Cdcuellar/Sistemas-embebidos---Actividades-de-la-vida-diaria/esp32_1_hr_rstc_sd_master/esp32_1_hr_rtc_sd_master.png

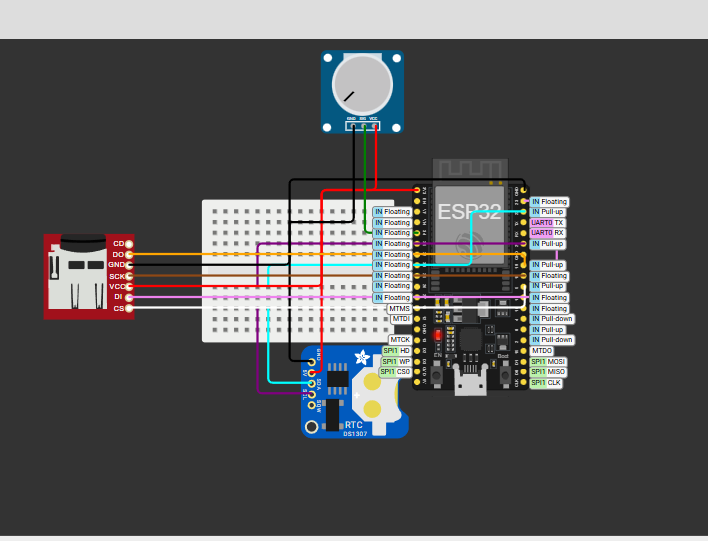
esp32_1_hr_rstc_sd_master/esp32_1_hr_rtc_sd_master.png
