Cdcuellar/Sistemas-embebidos---Actividades-de-la-vida-diaria/esp32_2/esp32_2.png

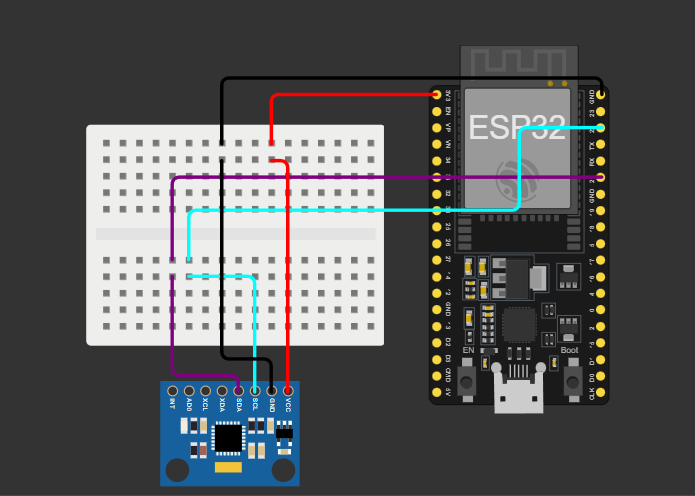
esp32_2/esp32_2.png
