Cdcuellar/Sistemas-embebidos---Actividades-de-la-vida-diaria/sta_wifi/build_output.txt

Checking Python dependencies...
Python requirements are satisfied.

Constraint file: C:\Espressif\tools\espidf.constraints.v6.0.txt

Requirement files:

 - C:\esp\v6.0\esp-idf\tools\requirements\requirements.core.txt

Python being checked: C:\Espressif\tools\python\v6.0\venv\Scripts\python.exe
Checking used Python interpreter...
Executing action: all (aliases: build)
Running cmake in directory C:\Users\Daniel\sta_wifi\build
Executing "cmake -G Ninja -B C:\Users\Daniel\sta_wifi\build -DPYTHON_DEPS_CHECKED=1 -DPYTHON=C:\Espressif\tools\python\v6.0\venv\Scripts\python.exe -DESP_PLATFORM=1 -DCCACHE_ENABLE=False C:\Users\Daniel\sta_wifi"...
-- IDF_TARGET is not set, guessed 'esp32' from sdkconfig 'C:/Users/Daniel/sta_wifi/sdkconfig'
-- Found Git: C:/Program Files/Git/cmd/git.exe (found version "2.51.2.windows.1")
-- Component directory C:/esp/v6.0/esp-idf/components/mqtt does not contain a CMakeLists.txt file. No component will be added
-- Minimal build - OFF
-- The C compiler identification is GNU 15.2.0
-- The CXX compiler identification is GNU 15.2.0
-- The ASM compiler identification is GNU
-- Found assembler: C:/Espressif/tools/xtensa-esp-elf/esp-15.2.0_20251204/xtensa-esp-elf/bin/xtensa-esp32-elf-gcc.exe
-- Detecting C compiler ABI info
-- Detecting C compiler ABI info - done
-- Check for working C compiler: C:/Espressif/tools/xtensa-esp-elf/esp-15.2.0_20251204/xtensa-esp-elf/bin/xtensa-esp32-elf-gcc.exe - skipped
-- Detecting C compile features
-- Detecting C compile features - done
-- Detecting CXX compiler ABI info
-- Detecting CXX compiler ABI info - done
-- Check for working CXX compiler: C:/Espressif/tools/xtensa-esp-elf/esp-15.2.0_20251204/xtensa-esp-elf/bin/xtensa-esp32-elf-g++.exe - skipped
-- Detecting CXX compile features
-- Detecting CXX compile features - done
-- Building ESP-IDF components for target esp32
-- ESP-TEE is currently supported only on the esp32c6;esp32h2;esp32c5;esp32c61 SoCs
-- KCONFIG_REPORT_VERBOSITY not set, using default
-- Project sdkconfig file C:/Users/Daniel/sta_wifi/sdkconfig
C:\Espressif\tools\python\v6.0\venv\Scripts\python.exe : Configuration Report  
             
En C:\Espressif\tools\Microsoft.v6.0.PowerShell_profile.ps1: 96 Carácter: 5
+     C:\Espressif\tools\python\v6.0\venv\Scripts\python.exe C:\esp\v6. ...
+     ~~~~~~~~~~~~~~~~~~~~~~~~~~~~~~~~~~~~~~~~~~~~~~~~~~~~~~~~~~~~~~~~~
    + CategoryInfo          : NotSpecified: (Configuration Report              
     :String) [], RemoteException
    + FullyQualifiedErrorId : NativeCommandError

+---------------------------------+

|  Parser Version: 1              |

|  Verbosity: default             |

|  Defaults policy: sdkconfig     |

|  Status: Finished successfully  |

|                                 |

+---------------------------------+

-- Compiler supported targets: xtensa-esp-elf
-- Detecting C compiler ABI info
-- Detecting C compiler ABI info - done
-- Detecting CXX compiler ABI info
-- Detecting CXX compiler ABI info - done
-- Detecting C compiler ABI info
-- Detecting C compiler ABI info - done
-- Detecting CXX compiler ABI info
-- Detecting CXX compiler ABI info - done
-- App "sta_wifi" version: 4402120-dirty
-- Found Python3: C:/Espressif/tools/python/v6.0/venv/Scripts/python.exe (found version "3.13.12") found components: Interpreter
-- Performing Test CMAKE_HAVE_LIBC_PTHREAD
-- Performing Test CMAKE_HAVE_LIBC_PTHREAD - Success
-- Found Threads: TRUE
-- Performing Test C_COMPILER_SUPPORTS_WFORMAT_SIGNEDNESS
-- Performing Test C_COMPILER_SUPPORTS_WFORMAT_SIGNEDNESS - Success
-- Setting up mbedtls configuration
-- Linkage type is PUBLIC
-- Adding linker script C:/esp/v6.0/esp-idf/components/esp_system/ld/esp32/memory.ld.in
--   -> Preprocessing .in script: C:/esp/v6.0/esp-idf/components/esp_system/ld/esp32/memory.ld.in
-- Adding linker script C:/esp/v6.0/esp-idf/components/esp_system/ld/esp32/sections.ld.in
--   -> Preprocessing .in script: C:/esp/v6.0/esp-idf/components/esp_system/ld/esp32/sections.ld.in
--   -> Applying ldgen processing: C:/Users/Daniel/sta_wifi/build/esp-idf/esp_system/ld/sections.ld.in
-- Adding linker script C:/esp/v6.0/esp-idf/components/esp_rom/esp32/ld/esp32.rom.ld
-- Adding linker script C:/esp/v6.0/esp-idf/components/esp_rom/esp32/ld/esp32.rom.api.ld
-- Adding linker script C:/esp/v6.0/esp-idf/components/esp_rom/esp32/ld/esp32.rom.libgcc.ld
-- Adding linker script C:/esp/v6.0/esp-idf/components/esp_rom/esp32/ld/esp32.rom.libc-funcs.ld
-- Adding linker script C:/esp/v6.0/esp-idf/components/soc/esp32/ld/esp32.peripherals.ld
