Cdcuellar/Sistemas-embebidos---Actividades-de-la-vida-diaria/esp32_2/prueba_de_funcionamiento.txt

PRUEBA DE FUNCIONAMIENTO - LOG SERIAL MPU6050
Fecha: 2026-04-06
Fuente: monitor serial ESP-IDF (COM3)

1) ARRANQUE Y CALIBRACION
I (486) NODO2_MPU6050: Arranque Nodo Esclavo #2 MPU6050
I (536) MPU6050: WHO_AM_I = 0x72 (addr=0x68)
I (686) NODO2_MPU6050: Calibrando MPU6050 en reposo...
I (2686) MPU6050: Calibracion completada
I (4576) NODO2_MPU6050: Referencia de postura lista (pie): [1.00 -0.00 0.00]

2) EVIDENCIA PARADO
I (7776) NODO2_MPU6050: Acc:1.000,-0.002,0.007 g | Gyr:0.09,0.12,0.86 dps | Roll:-12.3 Pitch:-89.6 | Estado:PARADO
I (8276) NODO2_MPU6050: Acc:1.004,-0.009,0.000 g | Gyr:0.07,0.36,-0.41 dps | Roll:-87.2 Pitch:-89.5 | Estado:PARADO

3) EVIDENCIA CAMINANDO
I (23776) NODO2_MPU6050: Acc:0.748,-0.650,0.243 g | Gyr:1.89,19.02,48.17 dps | Roll:-69.5 Pitch:-47.1 | Estado:CAMINANDO
I (25776) NODO2_MPU6050: Acc:0.756,-0.627,0.117 g | Gyr:-3.42,15.10,18.41 dps | Roll:-79.4 Pitch:-49.9 | Estado:CAMINANDO

4) EVIDENCIA CAIDA
I (10276) NODO2_MPU6050: Acc:-0.191,-0.875,0.554 g | Gyr:10.75,-4.95,0.00 dps | Roll:-57.7 Pitch:10.5 | Estado:CAIDA
I (32776) NODO2_MPU6050: Acc:-0.232,0.235,0.959 g | Gyr:1.91,5.07,7.78 dps | Roll:13.8 Pitch:13.2 | Estado:CAIDA

5) EVIDENCIA ACOSTADO
I (14776) NODO2_MPU6050: Acc:-0.201,-0.862,0.557 g | Gyr:-0.14,-0.39,-0.72 dps | Roll:-57.1 Pitch:11.1 | Estado:ACOSTADO
I (17776) NODO2_MPU6050: Acc:-0.200,-0.856,0.562 g | Gyr:0.08,-0.03,0.11 dps | Roll:-56.7 Pitch:11.1 | Estado:ACOSTADO

6) COMUNICACION ESP-NOW (OK)
I (3876) NODO2_MPU6050: ESP-NOW enviado OK a C8:2E:18:67:2F:C4
I (25376) NODO2_MPU6050: ESP-NOW enviado OK a C8:2E:18:67:2F:C4
