Cdcuellar/Sistemas-embebidos---Actividades-de-la-vida-diaria/(commit log)

2026-03-31 Nodo 2: Implementación MPU6050 con FreeRTOS y Power Management
2026-03-31 Agregada herramienta de diagnostico WHO_AM_I para MPU6050 y readme
2026-04-05 Add esp_32_s3_touch_1.28: Monitor Touch - Nodo Slave (IMU ESP-NOW TX, Doxygen)
2026-04-05 Actualizar nodo ESP32 MPU6050 y documentacion Doxygen
2026-04-05 Add Doxygen documentation to master controller (espnow_example_main.c)
    - Complete function documentation with @author, @param, @return, @details
    - File header with architecture overview, hardware specs, power optimizations
    - Documented all main functions: task_pulso, task_sd_log, cb_recepcion, RTC operations
    - Added Doxyfile for HTML documentation generation
    - Removed changelog section from file header
2026-04-05 Add HardwareX academic article in Word (.docx) format for WHO_AM_I MPU6050 tool
    Agent-Logs-Url: https://github.com/Cdcuellar/Sistemas-embebidos---Actividades-de-la-vida-diaria/sessions/607cdb44-f976-4874-b7fe-329faa08921d
2026-04-05 Complete project upload: ESP32 master controller firmware with documentation
    - All source files and configuration
    - Doxygen-documented code
    - Build configuration (CMakeLists.txt, Kconfig)
    - Project structure and documentation files
2026-04-05 Add HardwareX academic article Word document for wearable monitoring system
    Agent-Logs-Url: https://github.com/Cdcuellar/Sistemas-embebidos---Actividades-de-la-vida-diaria/sessions/e8cbee23-ceaa-43b8-9d4a-084ef824b407
2026-04-05 Update article: prototype validation section + power sources per node
    Agent-Logs-Url: https://github.com/Cdcuellar/Sistemas-embebidos---Actividades-de-la-vida-diaria/sessions/a33d6662-4167-4f7c-838b-b86a53d1d2db
2026-04-05 Update articulo HardwareX: remove schematic, COP prices, fix 3 nodes, clarify WHO_AM_I as software
    Agent-Logs-Url: https://github.com/Cdcuellar/Sistemas-embebidos---Actividades-de-la-vida-diaria/sessions/9869bd4c-6d17-46be-b7c7-fa106ccb5758
2026-04-05 BOM: precios reales Colombia (Mercado Libre), ESP32-S3 prestado por Universidad del Cauca ($0)
    Agent-Logs-Url: https://github.com/Cdcuellar/Sistemas-embebidos---Actividades-de-la-vida-diaria/sessions/83b5507b-537a-4693-a15e-4b9ddc440c03
2026-04-05 BOM: módulo SD (no microSD), tarjeta 4 GB, protoboard v1/soldadura v2, total $246,400 COP
    Agent-Logs-Url: https://github.com/Cdcuellar/Sistemas-embebidos---Actividades-de-la-vida-diaria/sessions/4ce4c13c-3e64-4f59-bd21-ec02bff63d2d
2026-04-05 BOM y conexiones: eliminar resistencias 4.7 kΩ pull-up I2C, total $245,400 COP
    Agent-Logs-Url: https://github.com/Cdcuellar/Sistemas-embebidos---Actividades-de-la-vida-diaria/sessions/10a99c71-343b-4513-898a-05d19e932d1e
2026-04-07 Agregar imagen de conexiones del nodo esp32_2
2026-04-07 adicion de eventos y txt de el log probado
2026-04-07 actualiza Doxyfile con clasificacion de actividad y log de prueba
2026-04-07 Actualizar Doxygen y documentacion de clasificador
2026-04-07 Rename Actividades de la Vida Diaria (1) (1).pdf to Actividades de la Vida Diaria.pdf
2026-04-11 Prueba esp32 wifi
